ProfessionalEngineer23/Smart-Home-Panel/Thread-Border-Router/README.md

# Files for Thread Border Router Esp32C6
