ProfessionalEngineer23/Smart-Home-Panel/images/Smart_Panel_Back.jpg

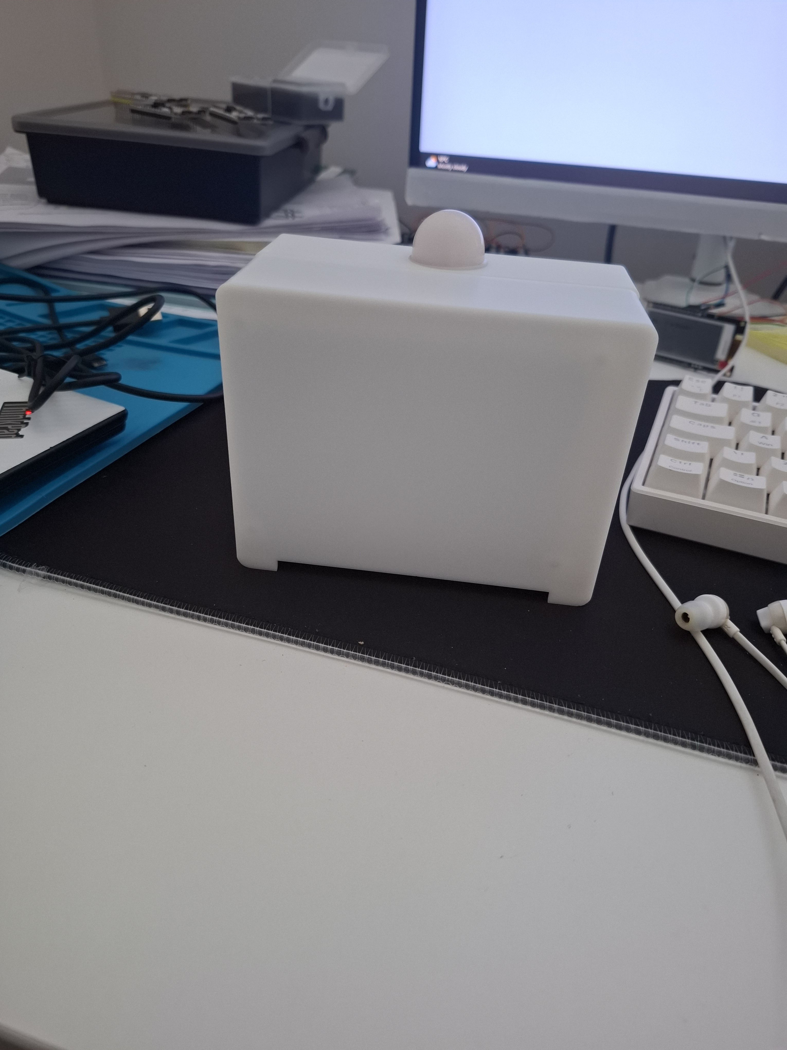
images/Smart_Panel_Back.jpg
