ProfessionalEngineer23/Smart-Home-Panel/images/Lab_Testing.jpg

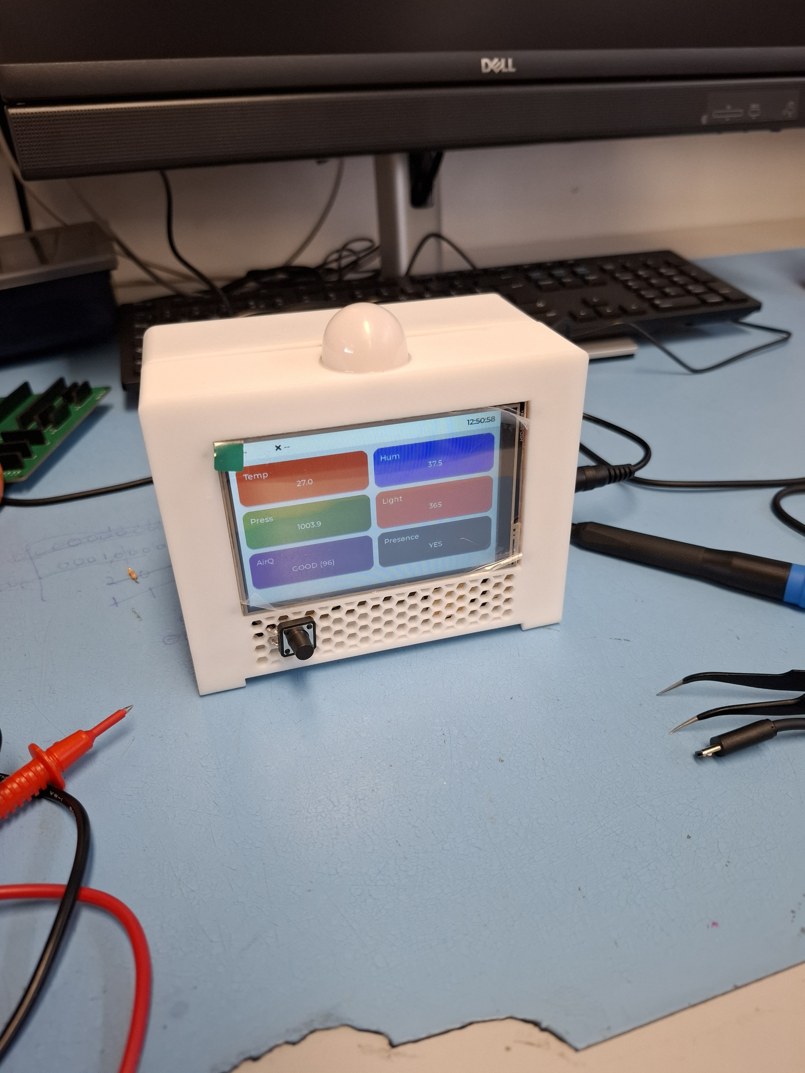
images/Lab_Testing.jpg
