ProfessionalEngineer23/Smart-Home-Panel/(commit log)

2026-05-01 Enclosure Drawings
2026-07-23 Firmware Flow/State Diagrams
